chenxuuu/chenxuuu-kicad-lib/README.md

# 晨旭自用 Kicad 元件库

元件库实测支持版本为8（理论上6以上格式兼容）

## 导入方法

请将此仓库，clone至电脑的适当位置

### 符号库

打开`符号编辑器`，点击菜单`文件`--`添加库`，选中仓库下的`symbols\chenxuuu_Library.kicad_sym`文件导入即可

### 封装库

打开`封装编辑器`，点击菜单`文件`--`添加库`，选中仓库下的`footprints\chenxuuu_Module.pretty`文件夹导入即可

### 3D模型

在Kicad主界面，点击菜单`偏好设置`--`路径配置`，在`环境变量`添加以下内容：

|名称|路径|
|-|-|
|chenxuuu_3d|你clone的这个仓库所在的路径，例如：D:\git\chenxuuu-kicad-lib|

## 更新

直接对仓库pull最新数据即可
