chenxuuu/chenxuuu-kicad-lib/(commit log)

2021-11-10 add: 初始的几个元器件
2021-11-22 add: xkt510和屏幕
2021-11-23 add: 屏和几个芯片
2021-11-23 add: 充电芯片
2021-11-23 update: 模型要用相对路径
2021-11-23 update: 添加库的方式写好一点
2021-11-23 add: tf卡
2021-11-24 add: 开关
2021-11-24 add: 小按键
2025-02-05 add: sf32、侧边按键3d模型
2025-02-05 update: 关于版本的描述
2025-02-05 add: 1.47寸lcd屏
2025-02-06 add: tf卡座、tvs
2025-02-06 add: tf卡模型
2025-02-06 add: tf卡座模型、编码器
2025-02-10 add: 拨码按键
2025-02-10 add: 镜像天线
2025-03-18 add: 加俩个元器件
2025-03-21 add: 又加几个元器件
2025-03-24 add: 几个隔离模块
2025-04-14 add: 多了几个元器件
2025-07-02 add: 一些封装
